shakeel-Ahamed-A/Logistics/PCB_Fabrication/FABRICATION_STATUS.md

# PROVISIONAL DESIGN - FABRICATION BLOCKED

Checked 17 October 2026 with KiCad 10.0.7. Continued the saved P0 design; no schematic, PCB, project or rule-file changes. No fabrication approval or shop archive issued.

| Status | Check | Result / exact evidence path |
|---|---|---|
| PASS | Native project preserved | `D:\Logistics\PCB_Fabrication\SmartLogistics.kicad_pro` (with same-basename `.kicad_sch`, `.kicad_pcb`, `.kicad_dru`); SHA-256 preservation evidence: `D:\Logistics\PCB_Fabrication\Evidence\native_preservation_audit.json` |
| PASS | ERC | 0 errors, 0 warnings: `D:\Logistics\PCB_Fabrication\ERC_Report.txt` |
| PASS | DRC after ground/power fixes | 0 violations, 0 unconnected pads, 0 schematic-parity issues; zones refilled in memory; exclusions included: `D:\Logistics\PCB_Fabrication\DRC_Report.txt` |
| PASS | Connectivity / library geometry | 153 connected pads match actual schematic netlist and intended map; all 63 footprints match local library pad geometry; separate AUX/Blue Pill 3.3V nets: `D:\Logistics\PCB_Fabrication\Evidence\connectivity_audit.json` |
| PASS | Actual schematic pin positions | 171 pin positions match embedded library geometry and wire endpoints/NC markers: `D:\Logistics\PCB_Fabrication\Evidence\pin_coordinate_audit.json` |
| PASS | Routing / planes | 377 track segments (225 at 0.8mm, 152 at 0.4mm), 12 vias, filled GND on both copper layers. Rules: clearance 0.3mm, copper-to-edge 0.5mm. `D:\Logistics\PCB_Fabrication\Evidence\trace_width_audit.json` |
| PASS | Review artifacts | Fresh exports visually inspected; paths below. Existing BOM and pin map revalidated without unnecessary edits. |
| PENDING | Hardware / firmware evidence | SW420 PB12 is proposed, not hardware-tested; older source uses PB15. OLED omitted until identified. No sensor failures are declared resolved. `D:\Logistics\PCB_Fabrication\Firmware_Required_Changes.txt` |
| BLOCKED | Physical / electrical release | Blue Pill spacing, actual component fit, module pin orders and circuitry, SD interface, source and shop capabilities remain unverified. Exact evidence list: `D:\Logistics\PCB_Fabrication\Verification_Required.csv` |
| BLOCKED | Manufacturing outputs | Gerbers, Excellon and `PCB_Fabrication_SHOP.zip` intentionally withheld. No Gerber inspection or fabrication approval claimed. |

PASS applies only to the stated CAD check. ERC/DRC retain the ignored checks listed in their reports; these are documented in `D:\Logistics\PCB_Fabrication\Validation_Summary.txt`. They cannot validate unknown external modules, real mechanical fit or safe operation.

## Current deliverables

- Schematic: `D:\Logistics\PCB_Fabrication\Schematic.pdf`
- Copper views: `D:\Logistics\PCB_Fabrication\PCB_Top.png` and `D:\Logistics\PCB_Fabrication\PCB_Bottom.png` (bottom viewed from underside; mirrored relative to top).
- Generic component 3D view: `D:\Logistics\PCB_Fabrication\PCB_3D.png`. Real Blue Pill/sensors are absent; generic LED model colours do not identify BOM colours.
- Assembly drawing: `D:\Logistics\PCB_Fabrication\Assembly_Drawing.pdf` (4 pages).
- Separate socket-fit sheet: `D:\Logistics\PCB_Fabrication\BluePill_Socket_Fit_1to1.pdf`. Print actual size / 100%, disable Fit-to-page, verify 50.00mm bar first. Proposed 15.24mm row spacing, 2.54mm pitch and 48.26mm pin-1-to-pin-20 span are CAD dimensions, not measurements of your module.
- BOM: `D:\Logistics\PCB_Fabrication\BOM.csv` (63 entries; procurement/assembly provisional).
- Pin map: `D:\Logistics\PCB_Fabrication\Pin_Mapping.csv` (171 symbol pins).
- Power calculations: `D:\Logistics\PCB_Fabrication\Power_Design.md`.
- Quotation specification: `D:\Logistics\PCB_Fabrication\Fabrication_Instructions.txt`.

Proposed board: **110 x 110mm, 2 copper layers, FR-4 1.6mm, 1oz copper, green mask both sides, white top legend, 2 boards**. Four M3 clearance holes: 3.2mm NPTH, 100 x 100mm centres. Header/socket holes 1.0mm; vias 0.5mm. Other drills: `D:\Logistics\PCB_Fabrication\Drill_Size_Audit.csv`. Shop acceptance is still required.

## What you must provide before release

1. **Blue Pill and sockets:** caliper-measured row centre spacing, pitch/span, module width/length, socket height and lead sizes, underside clearance and USB/SWD overhang; clear top/bottom photos showing all pin labels and regulator marking. Compare the printed fit sheet with the actual board.
2. **Modules and buzzer:** clear photos of both sides, every connector label and readable IC markings; module datasheets/schematics if available. SD needs regulator/interface IC identities, six-pin order, input supply range, 3.3V SPI input compatibility and MISO level. Identify RTC battery/charging circuitry, MPU AD0/VLOGIC and pull-ups, DHT minimum supply, GPS regulator/UART, SW420 pull-up, buzzer voltage/current/type, and the debugger model. These determine whether this draft needs electrical changes.
3. **Power and purchased parts:** identify a regulated 5V source with polarity, current limit and load capability; provide the actual component/socket part numbers or lead/body measurements. The 655mA budget / 819mA with margin are allowances, not measured maxima. Complete the relevant rail, pull-up, power-sequencing and current checks before electrical release. ST-LINK 3.3V and a raw lithium cell do not meet this input requirement.
4. **Shop response:** confirm 2-layer plated-through capability, 0.3mm clearance, 0.4mm signals / 0.8mm power, drill/annulus tolerances, 1.6mm/1oz stack, mask/silkscreen and finish, quantity 2, and turnaround before 21-22 October. Ask for acceptance of the exact drill audit, not only nominal header holes.

After those facts resolve the release blockers, approve the resulting verified revision. Any required changes must receive final ERC/DRC, connectivity and mechanical checks, followed by Gerber/Excellon export and inspection before creating the shop ZIP. Permission alone cannot substitute for the missing measurements/specifications.
