shakeel-Ahamed-A/Logistics/PCB_Fabrication/DRC_Report.txt

** Drc report for SmartLogistics.kicad_pcb **
** Created on 2026-10-17T07:41:33 **
** Report includes: Errors, Warnings, Exclusions **

** Found 0 DRC violations **

** Found 0 unconnected pads **

** Found 0 Footprint errors **

** Ignored checks **
    - Footprint has no courtyard defined
    - Track endpoint not centered on via
    - Tuning profile track geometries
    - Footprint doesn't match symbol's footprint filters
    - Footprint component type doesn't match footprint pads

** End of Report **
