shakeel-Ahamed-A/Logistics/PCB_Fabrication/ERC_Report.txt

ERC report (2026-10-17T07:41:31, Encoding UTF8)
Report includes: Errors, Warnings

***** Sheet /

 ** ERC messages: 0  Errors 0  Warnings 0

 ** Ignored checks:
    - Global label only appears once in the schematic
    - Four connection points are joined together
    - SPICE model issue
    - Assigned footprint doesn't match footprint filters
