shakeel-Ahamed-A/Logistics/PCB_Fabrication/Evidence/schematic_review.png

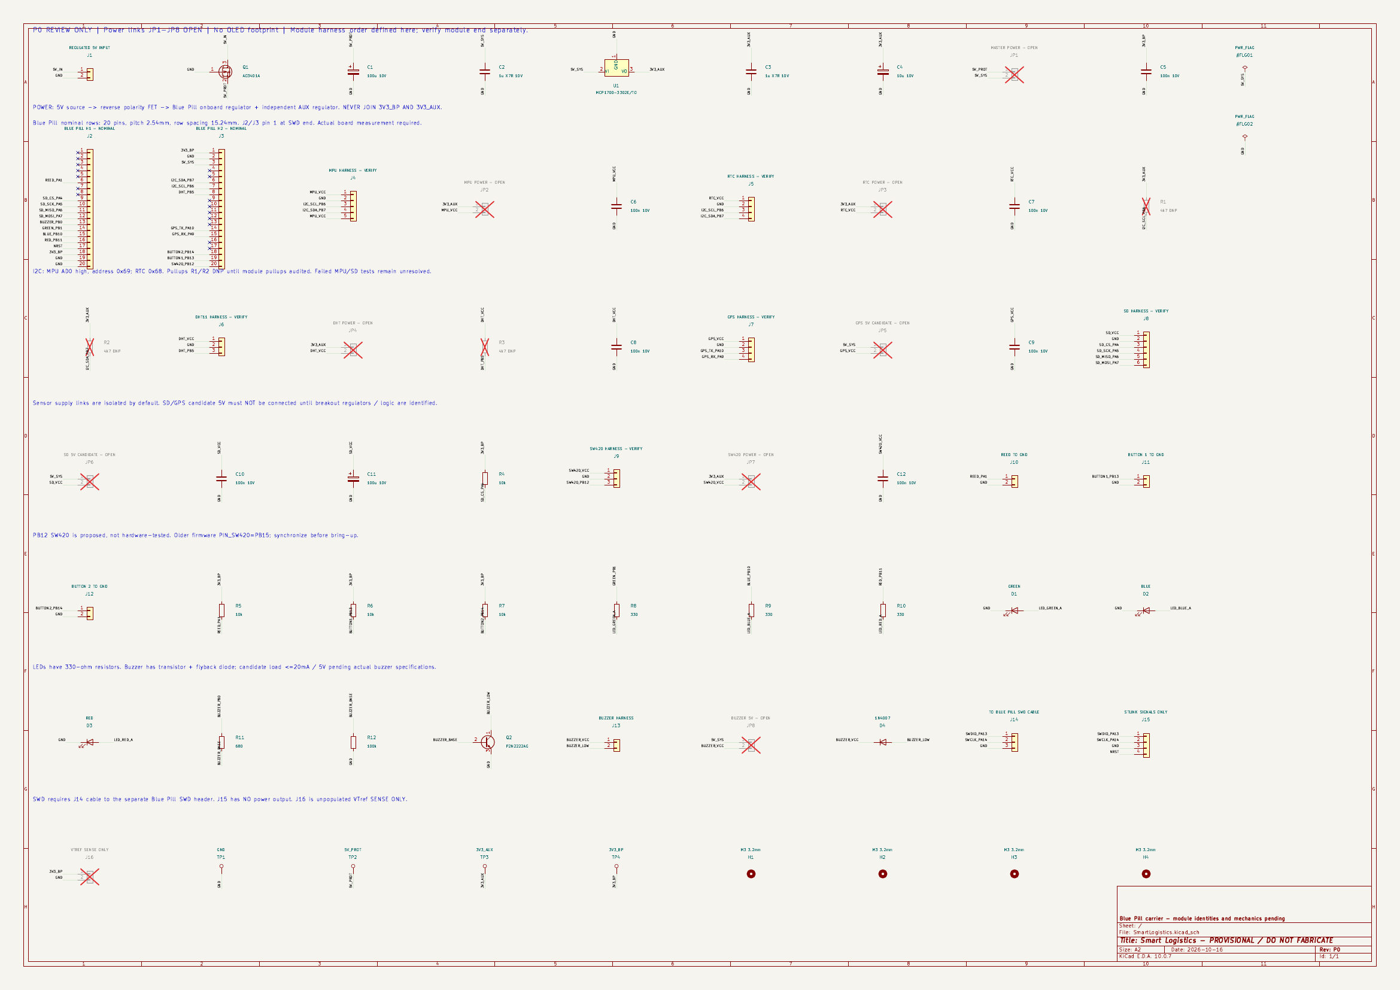
PCB_Fabrication/Evidence/schematic_review.png
