shakeel-Ahamed-A/Logistics/PCB_Fabrication/Assembly_Drawing.pdf

2 | 1 | 2

# BLUE PILL: SWD END USB / NO POWER

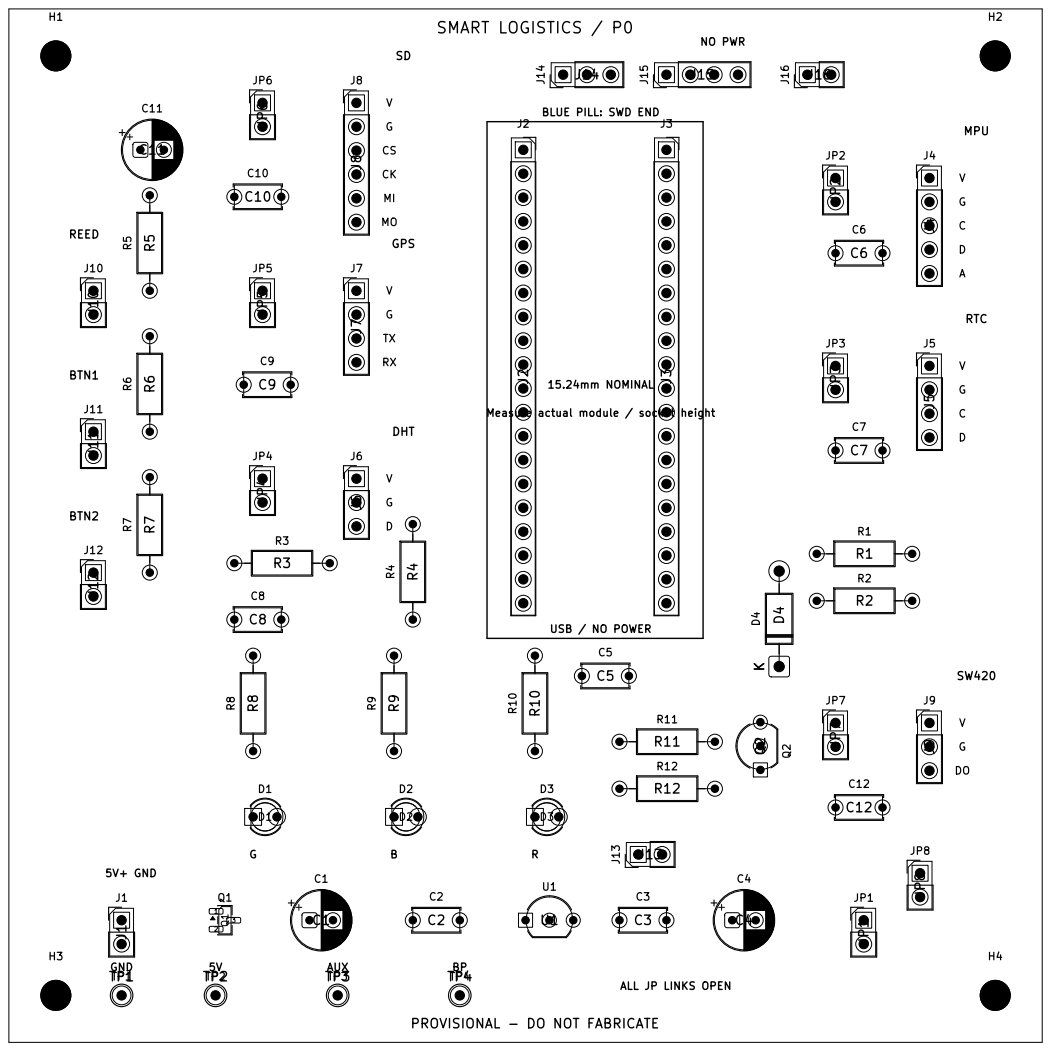
[picture p2: page 1]

SW420 PROVISIONAL - DO NOT FABRICATE

ALL JP LINKS OPEN

# Blue Pill socket fit check - print at 100%

P0 - PROVISIONAL / DO NOT FABRICATE - 16 October 2026

Check the 50 mm bar with a ruler before using this page.
Two rows: 20 pins, 2.54 mm pitch; proposed row spacing 15.24 mm. Pitch span pin 1 to pin 20 = 48.26 mm. Actual board still unmeasured. Top view: SWD end above; USB end below. Check actual pin labels.
J2 is the VBAT row; J3 is the 3V3/5V row. Do not mirror the carrier.
Measure module width/length/height, socket height and SWD/USB overhang. 3D rendering excludes the real Blue Pill and sensors: clearance is PENDING.
J2 / VBAT | J3 / 3V3

USB end

15.24 mm

50.00 mm calibration bar

FIT NOT APPROVED: compare this coupon with your actual board before fabrication.

# Carrier connector pinout - module end must be verified

P0 - PROVISIONAL / DO NOT FABRICATE - 16 October 2026

J1 REGULATED 5V INPUT
1=5V_IN | 2=GND

J4 MPU HARNESS - VERIFY
1=MPU_VCC | 2=GND | 3=I2C_SCL_PB6 | 4=I2C_SDA_PB7 | 5=MPU_VCC

J5 RTC HARNESS - VERIFY
1=RTC_VCC | 2=GND | 3=I2C_SCL_PB6 | 4=I2C_SDA_PB7

J6 DHT11 HARNESS - VERIFY
1=DHT_VCC | 2=GND | 3=DHT_PB5

J7 GPS HARNESS - VERIFY
1=GPS_VCC | 2=GND | 3=GPS_TX_PA10 | 4=GPS_RX_PA9

J8 SD HARNESS - VERIFY
1=SD_VCC | 2=GND | 3=SD_CS_PA4 | 4=SD_SCK_PA5 | 5=SD_MISO_PA6 | 6=SD_MOSI_PA7

J9 SW420 HARNESS - VERIFY
1=SW420_VCC | 2=GND | 3=SW420_PB12

J10 REED TO GND
1=REED_PA1 | 2=GND

J11 BUTTON 1 TO GND
1=BUTTON1_PB13 | 2=GND

J12 BUTTON 2 TO GND
1=BUTTON2_PB14 | 2=GND

J13 BUZZER HARNESS
1=BUZZER_VCC | 2=BUZZER_LOW

J14 TO BLUE PILL SWD CABLE
1=SWDIO_PA13 | 2=SWCLK_PA14 | 3=GND

# Carrier connector pinout - continued

P0 - PROVISIONAL / DO NOT FABRICATE - 16 October 2026

J15 STLINK SIGNALS ONLY
1=SWDIO_PA13 | 2=SWCLK_PA14 | 3=GND | 4=NRST

J16 VTREF SENSE ONLY
1=3V3_BP | 2=GND

JP1-JP8 OPEN; R1/R2/R3 and J16 DNP. Supply links do not isolate signal pins. No hot-plugging.
