shakeel-Ahamed-A/Logistics/PCB_Fabrication/Evidence/deliverable_manifest_2026-10-17.csv

File | Bytes | SHA256
SmartLogistics.kicad_pro | 10886 | E0B03D3DEB09930143914720F2330A69D12332298C9900A74E2AC4BA2886E590
SmartLogistics.kicad_sch | 122158 | 0117FFA0E297E57C0BC1CEB7E60B631A9887A0E6D31DAA01ED794CC223B14C6B
SmartLogistics.kicad_pcb | 934197 | 785D359CF4CCF2E02C0F8CE3CC1FE7EC6728022C070E47972B8DF3F7502BA60E
Schematic.pdf | 239423 | 2B0F0AB58E1A72B0EDD6D653A7BE5641440691FF0424902957333B341672E528
PCB_Top.png | 135147 | 4C4996BE035E1A4967922B69DF3953BAA0C7BEB60CA14EB94CC90923F4AF2416
PCB_Bottom.png | 92383 | 9AC5950159DA061FB94056811526A578A12254003A93DCA5F60C3259492A8214
PCB_3D.png | 937522 | 4A041196A1BA4F14B52FE7E1CF56EB233078E97ABADD62933EB77A4D6111E7F5
BOM.csv | 8652 | C178DC051E8BF49569F7BF5DF030CC4750218132B17C67C21DA6A05D34F6706A
Assembly_Drawing.pdf | 130162 | F259F997493364847925471E2DCD3E82919324C1B30040D9BC3572363D42DDE5
BluePill_Socket_Fit_1to1.pdf | 6426 | 0789B1E35FCFAD7AD71749B9A85609A1791B13582C4183AB9BE37BB0E3D516BD
Pin_Mapping.csv | 25627 | 8E9D8F09611E90FA6A64925881F6A8D188995335085CBC049EA41CE146AE5B6F
ERC_Report.txt | 357 | FDBCACB988917C4F417336B03FF8CD654F0D8062EE86C7E238AA134C578A87F8
DRC_Report.txt | 527 | 259289A7A92B25DFC1020222DE931174C3F6F8B82DF2706BD198CFBFE46B3561
FABRICATION_STATUS.md | 5954 | 6B650A23724ACC0A3386B8631878AAA5DEBCD6B808A0D79F757B112968E7C7D5
Validation_Summary.txt | 3446 | 2B7027F9833E677A411DC9A17BABC8180BBE37B08D0E36B4CF4C59D73FB6B27B
Fabrication_Instructions.txt | 2612 | E7D7039D299556E405F621EAA11292CCCA48B4EC702ACFF4631DE08058164A96
