shakeel-Ahamed-A/Logistics/PCB_Fabrication/Evidence/assembly_review-1.png

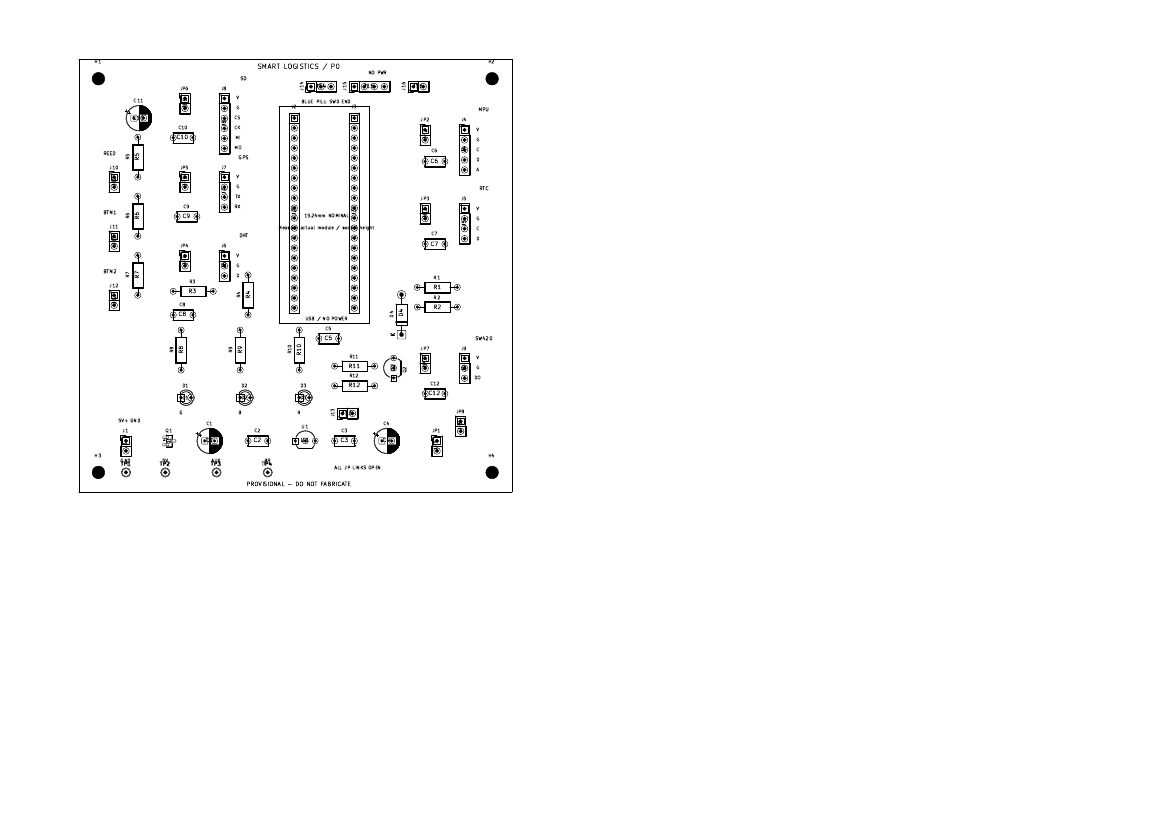
PCB_Fabrication/Evidence/assembly_review-1.png
