shakeel-Ahamed-A/Logistics/PCB_Fabrication/Evidence/assembly_review-2.png

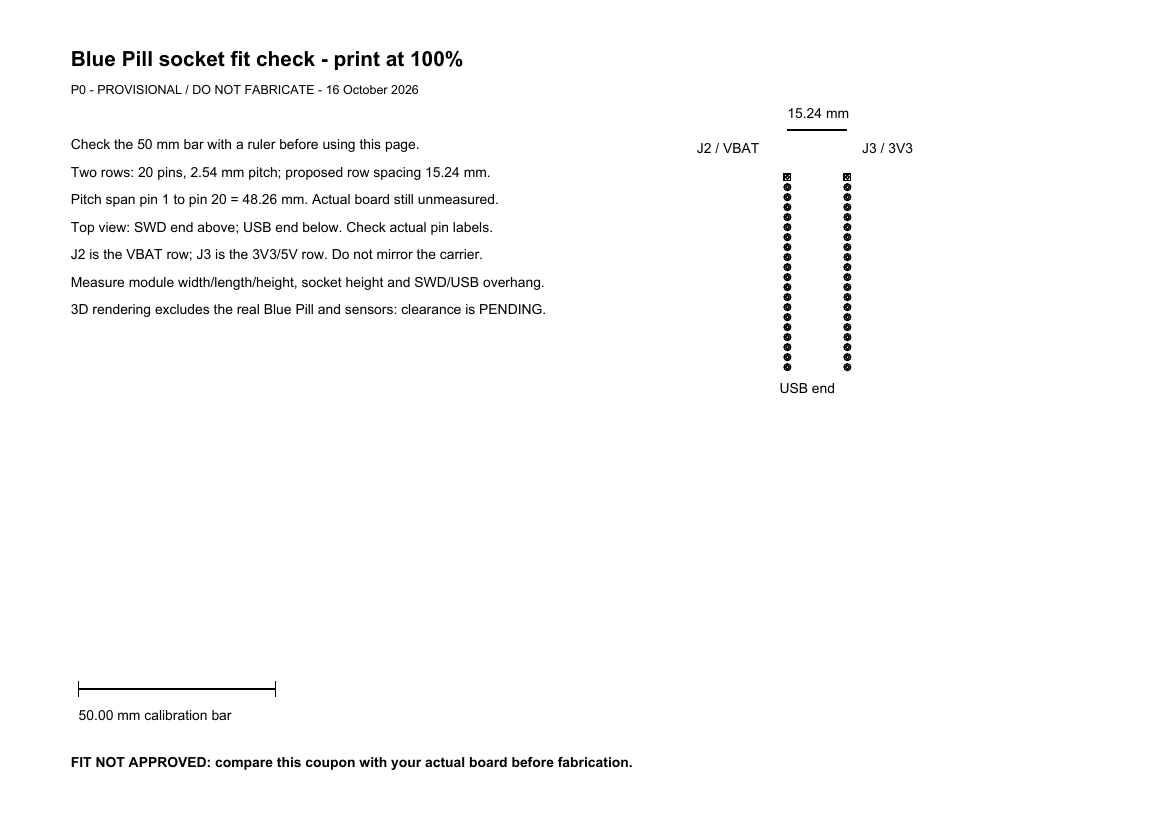
PCB_Fabrication/Evidence/assembly_review-2.png
