shakeel-Ahamed-A/Logistics/PCB_Fabrication/Evidence/assembly_review-3.png

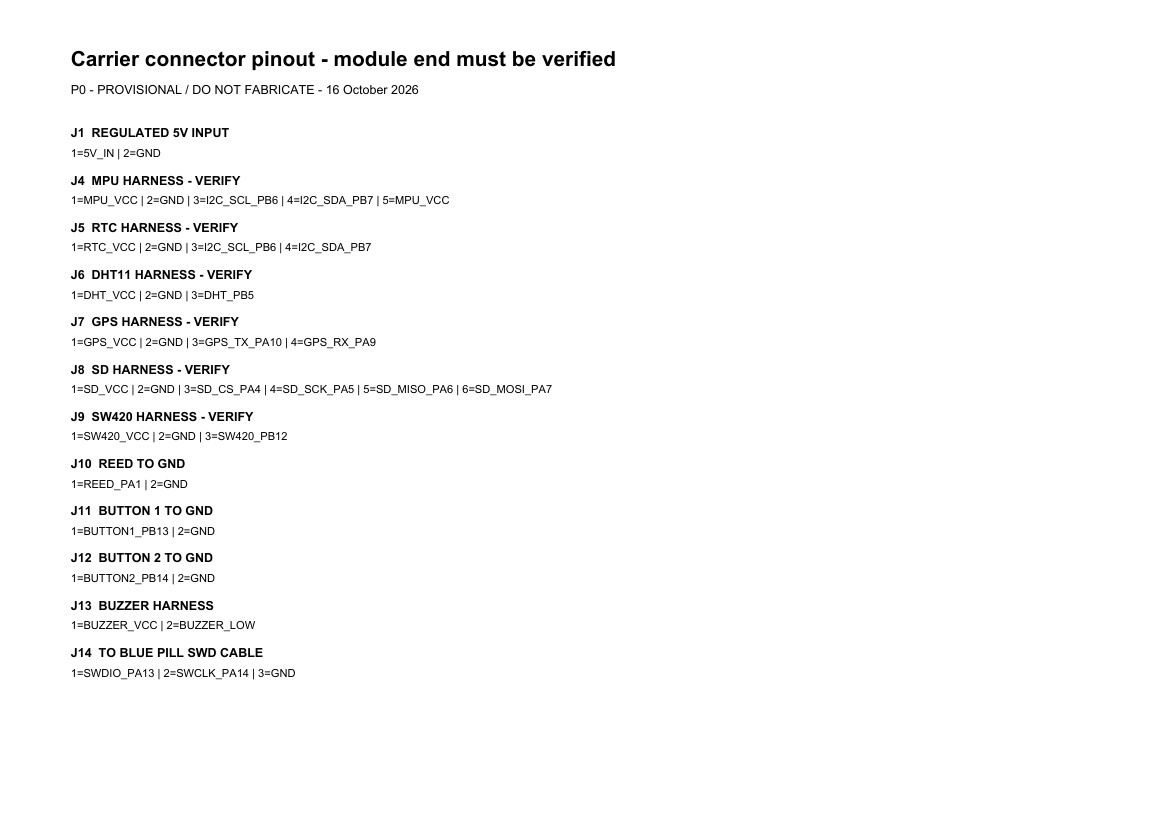
PCB_Fabrication/Evidence/assembly_review-3.png
