shakeel-Ahamed-A/Logistics/PCB_Fabrication/Evidence/assembly_review-4.png

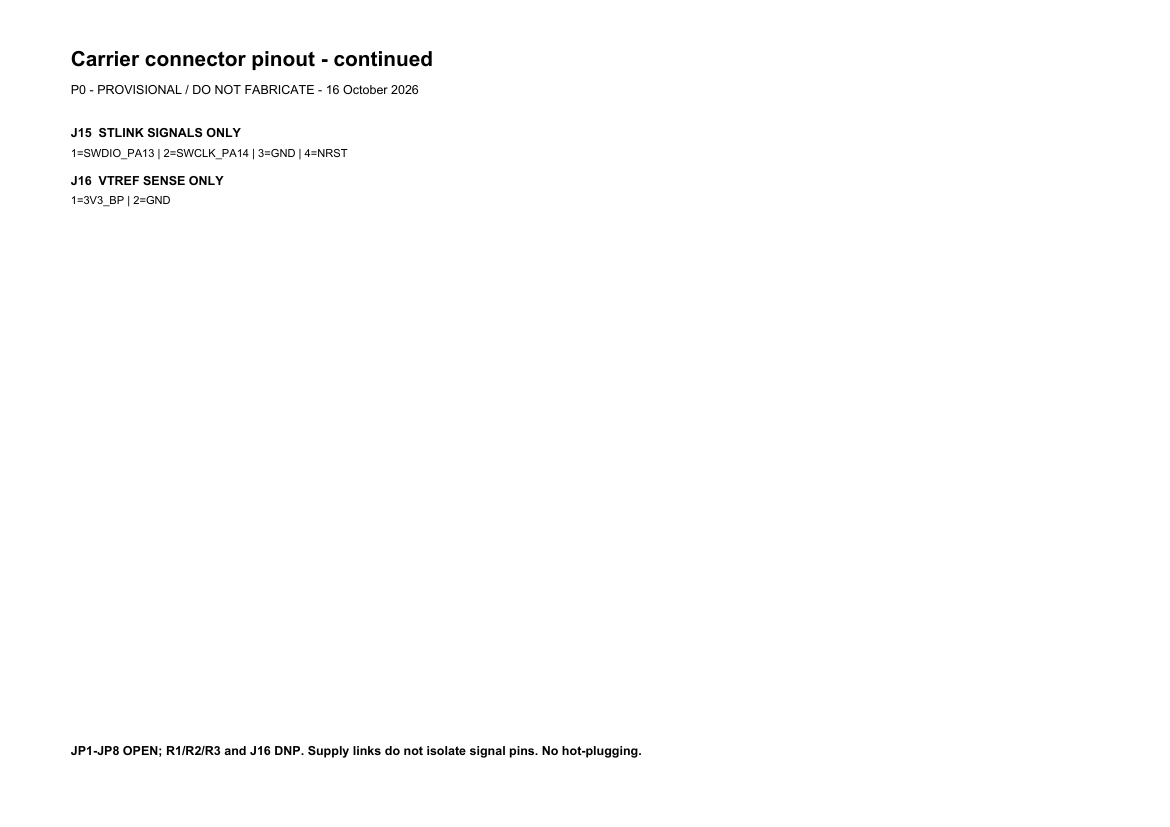
PCB_Fabrication/Evidence/assembly_review-4.png
