shakeel-Ahamed-A/Logistics/PCB_Fabrication/PCB_3D.png

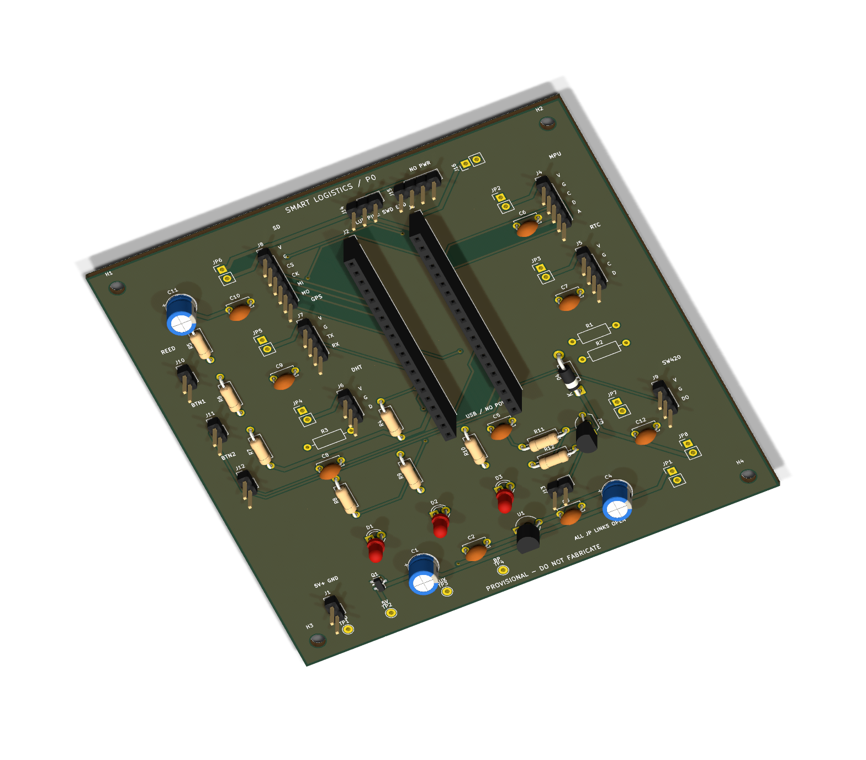
PCB_Fabrication/PCB_3D.png
