shakeel-Ahamed-A/Logistics/PCB_Fabrication/PCB_Bottom.png

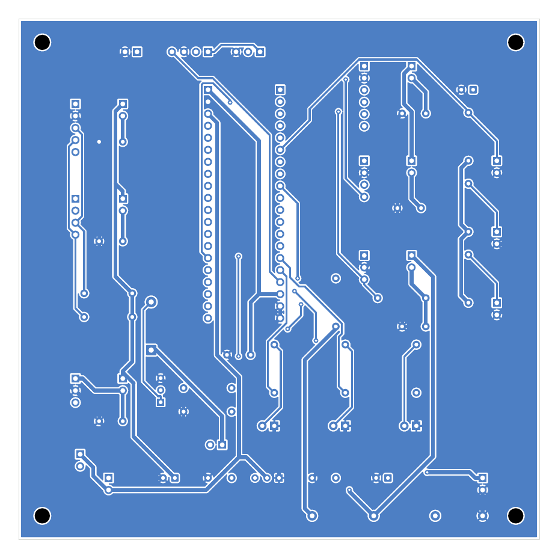
PCB_Fabrication/PCB_Bottom.png
