shakeel-Ahamed-A/Logistics/PCB_Fabrication/PCB_Top.png

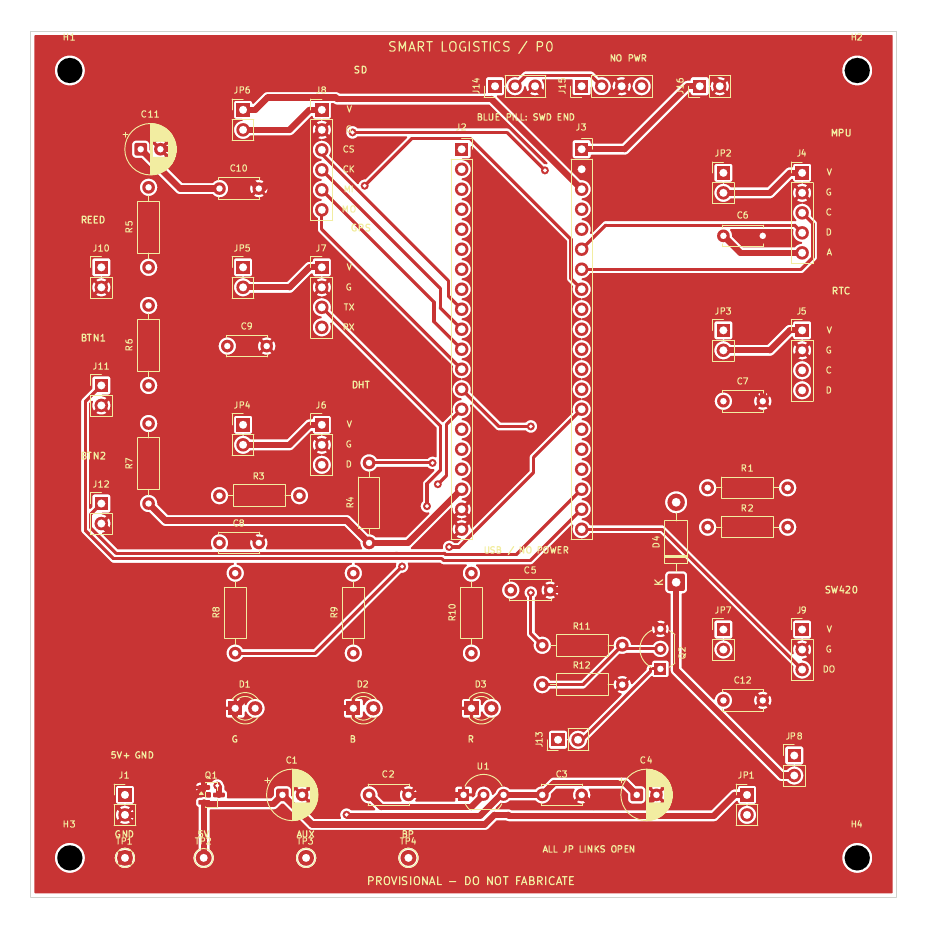
PCB_Fabrication/PCB_Top.png
