shakeel-Ahamed-A/Logistics/PCB_Fabrication/Schematic.pdf

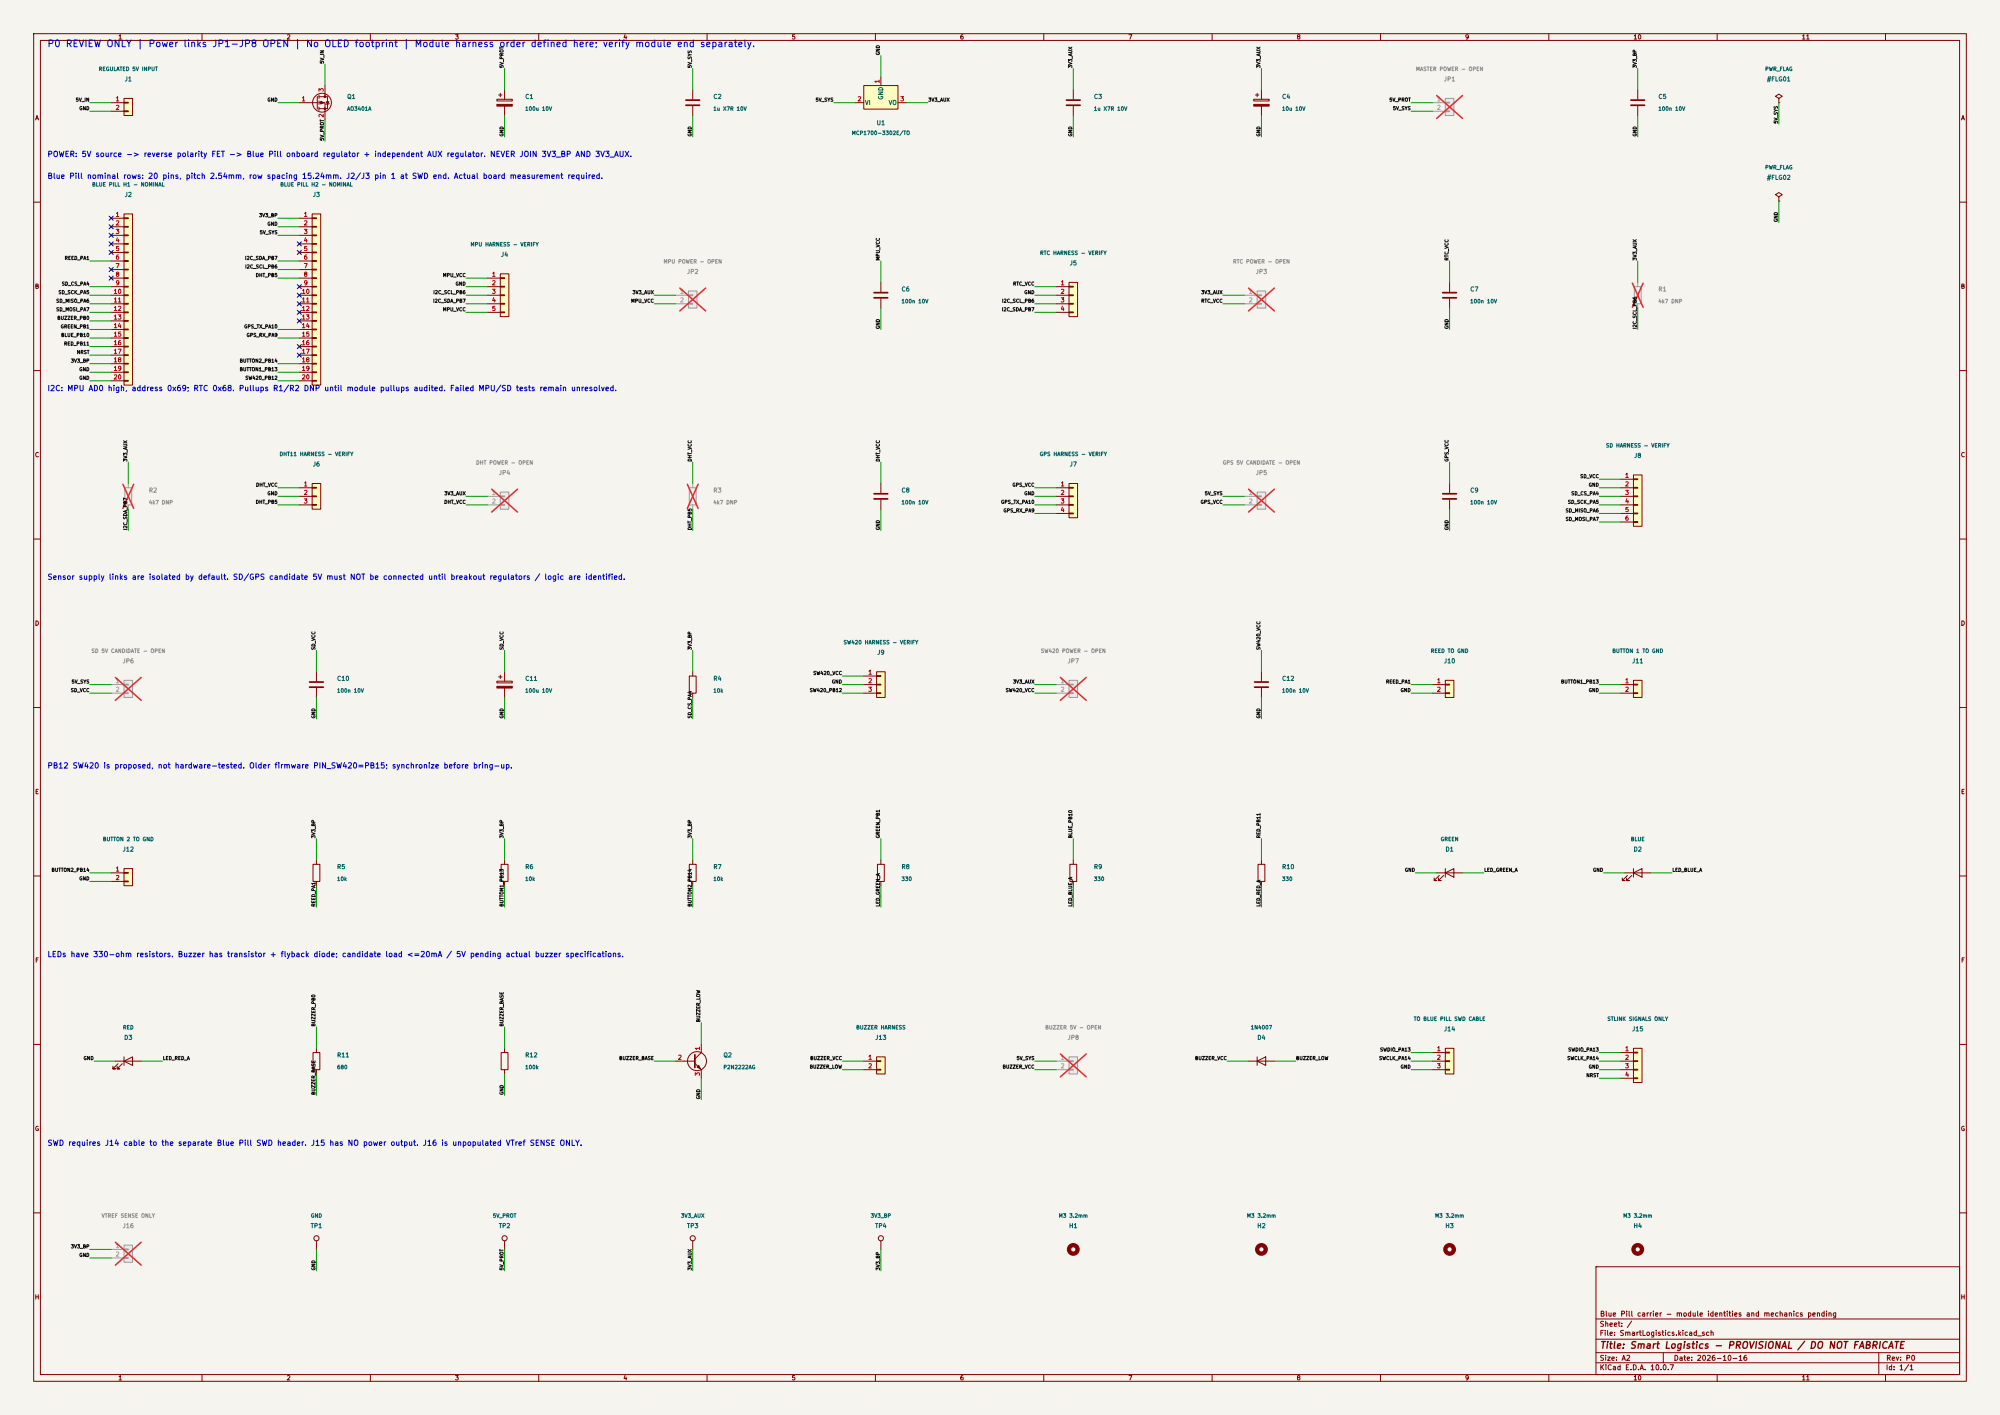
[picture p10: page 1]

P0 REVIEW ONLY | Power links JP1-JP8 OPEN | No OLED footprint | Module harness order defined here; verify module end separately.

POWER: 5V source -> reverse polarity FET -> Blue Pill onboard regulator + independent AUX regulator. NEVER JOIN 3V3_BP AND 3V3_AUX.

Blue Pill nominal rows: 20 pins, pitch 2.54mm, row spacing 15.24mm. J2/J3 pin 1 at SWD end. Actual board measurement required.

I2C: MPU AD0 high, address 0x69; RTC 0x68. Pullups R1/R2 DNP until module pullups audited. Failed MPU/SD tests remain unresolved.

Sensor supply links are isolated by default. SD/GPS candidate 5V must NOT be connected until breakout regulators / logic are identified.

GND LEDs have 330-ohm resistors. Buzzer has transistor + flyback diode; candidate load <=20mA / 5V pending actual buzzer specifications.

PB12 SW420 is proposed, not hardware-tested. Older firmware PIN_SW420=PB15; synchronize before bring-up.

SWD requires J14 cable to the separate Blue Pill SWD header. J15 has NO power output. J16 is unpopulated VTref SENSE ONLY.

Blue Pill carrier - module identities and mechanics pending
Sheet: /
File: SmartLogistics.kicad_sch
Title: Smart Logistics - PROVISIONAL / DO NOT FABRICATE

Size: A2 | Rev: P0
KiCad E.D.A. 10.0.7 | Id: 1/1
