shakeel-Ahamed-A/Logistics/PCB_Fabrication/Evidence/Assembly_1to1.pdf

SMART LOGISTICS / P0
BLUE PILL: SWD END USB / NO POWER

SW420 PROVISIONAL - DO NOT FABRICATE

ALL JP LINKS OPEN
