shakeel-Ahamed-A/Logistics/PCB_Fabrication/Evidence/PCB_Bottom.pdf

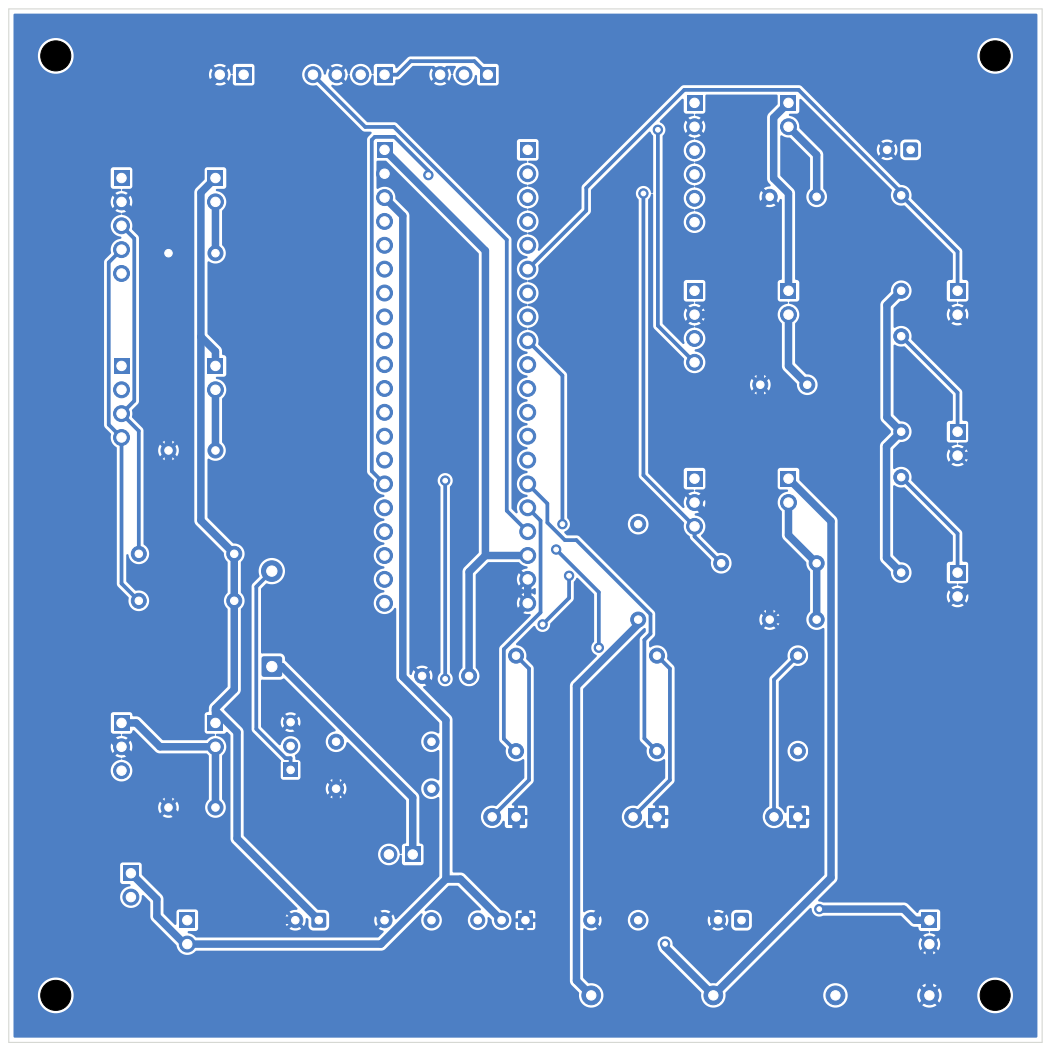
[picture p11: page 1]
