shakeel-Ahamed-A/Logistics/(list of files, drawings)

Other design files:
PCB_Fabrication/Evidence/SmartLogistics.dsn
