shakeel-Ahamed-A/Logistics/PCB_Fabrication/SmartLogistics.kicad_pcb

## KiCad design PCB_Fabrication/SmartLogistics.kicad_pcb (2026-10-17)

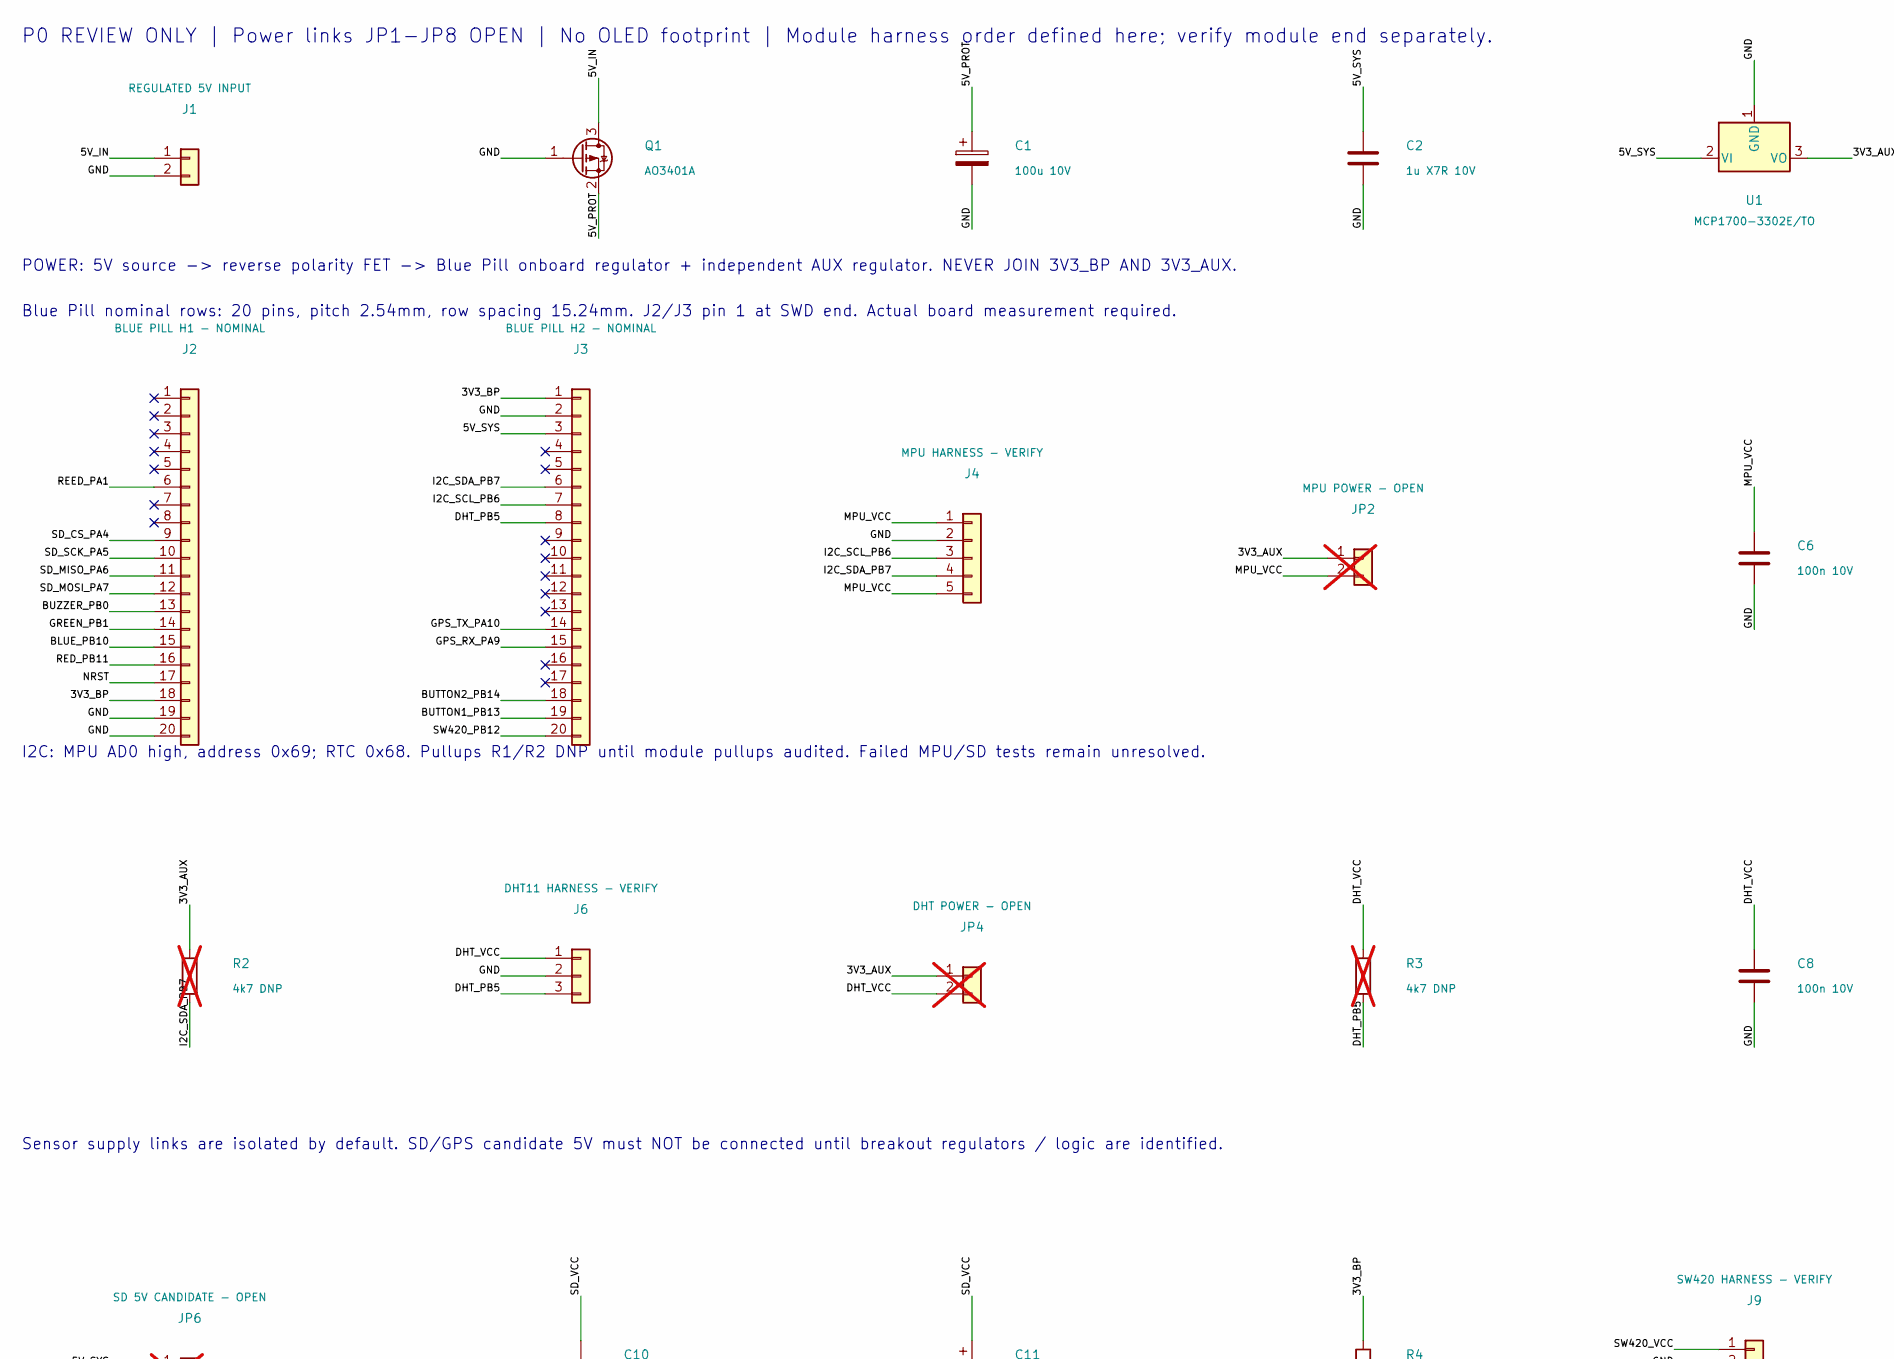
[picture p12: schematic SmartLogistics.kicad_sch, Smart Logistics - PROVISIONAL / DO NOT FABRICATE, part in row 1, column 1]

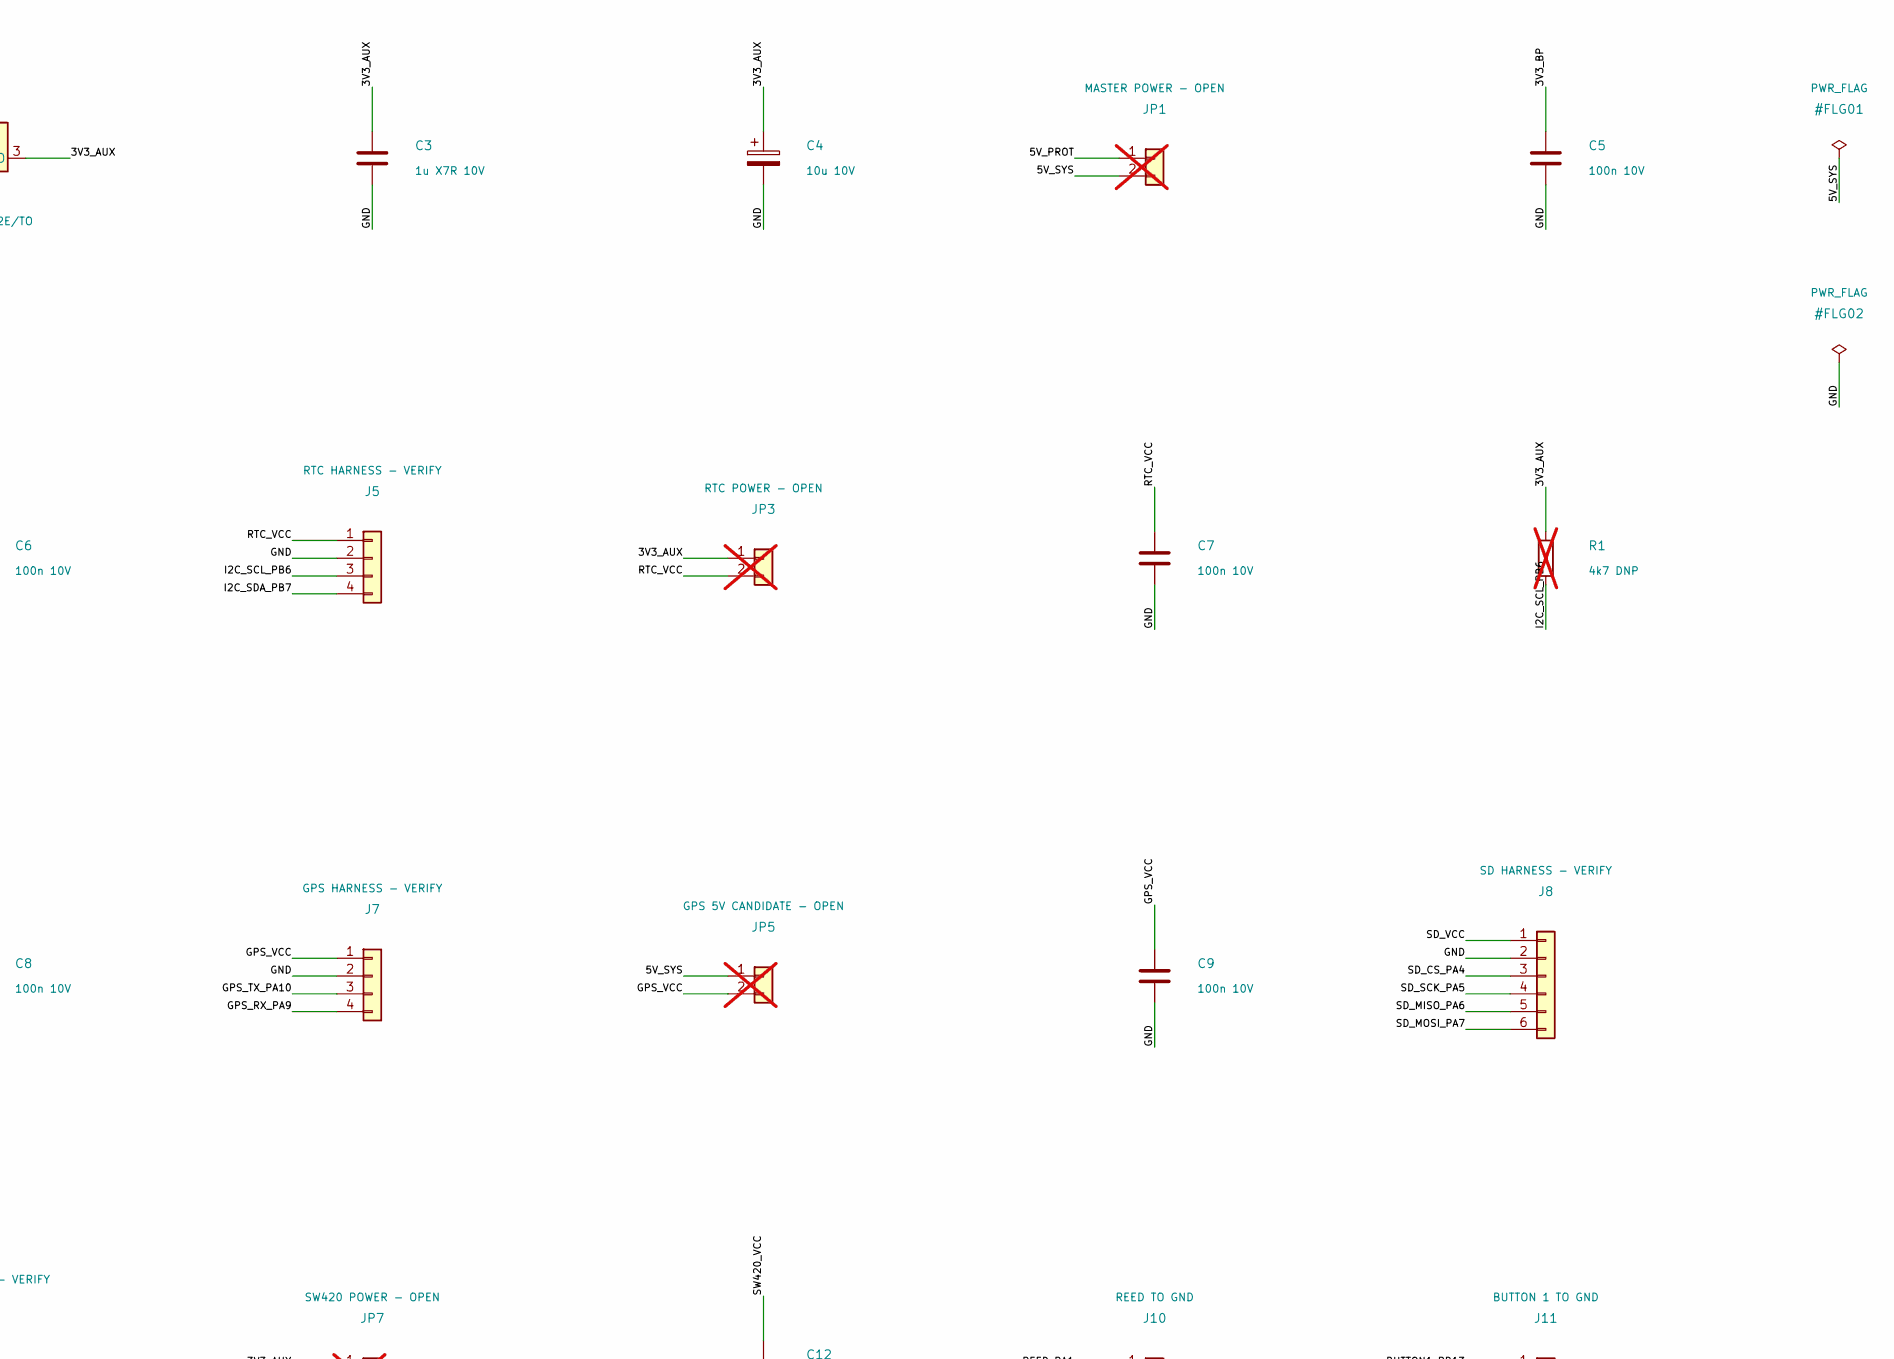
[picture p13: schematic SmartLogistics.kicad_sch, Smart Logistics - PROVISIONAL / DO NOT FABRICATE, part in row 1, column 2]

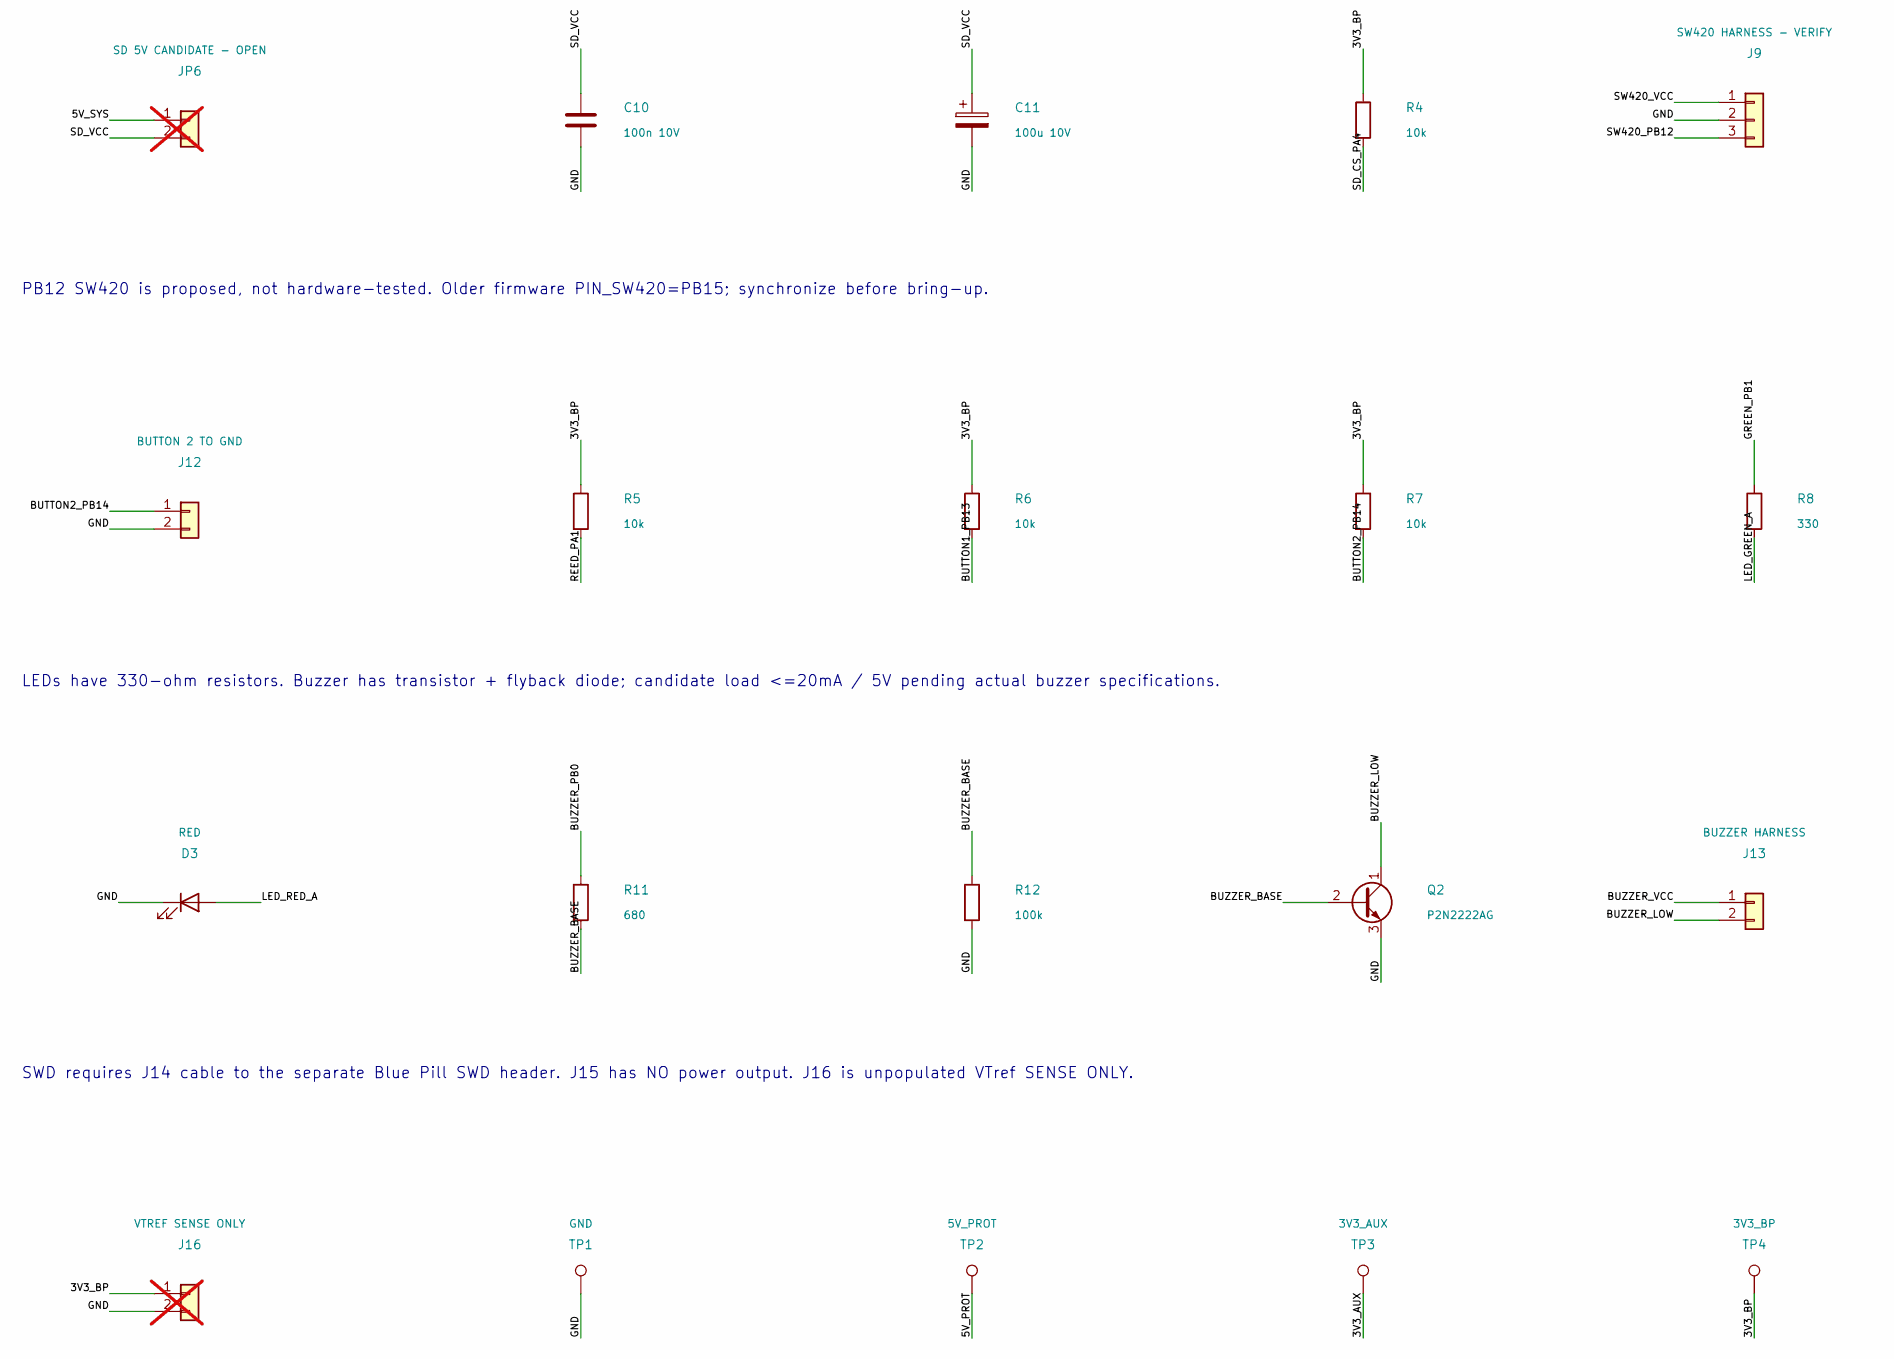
[picture p14: schematic SmartLogistics.kicad_sch, Smart Logistics - PROVISIONAL / DO NOT FABRICATE, part in row 2, column 1]

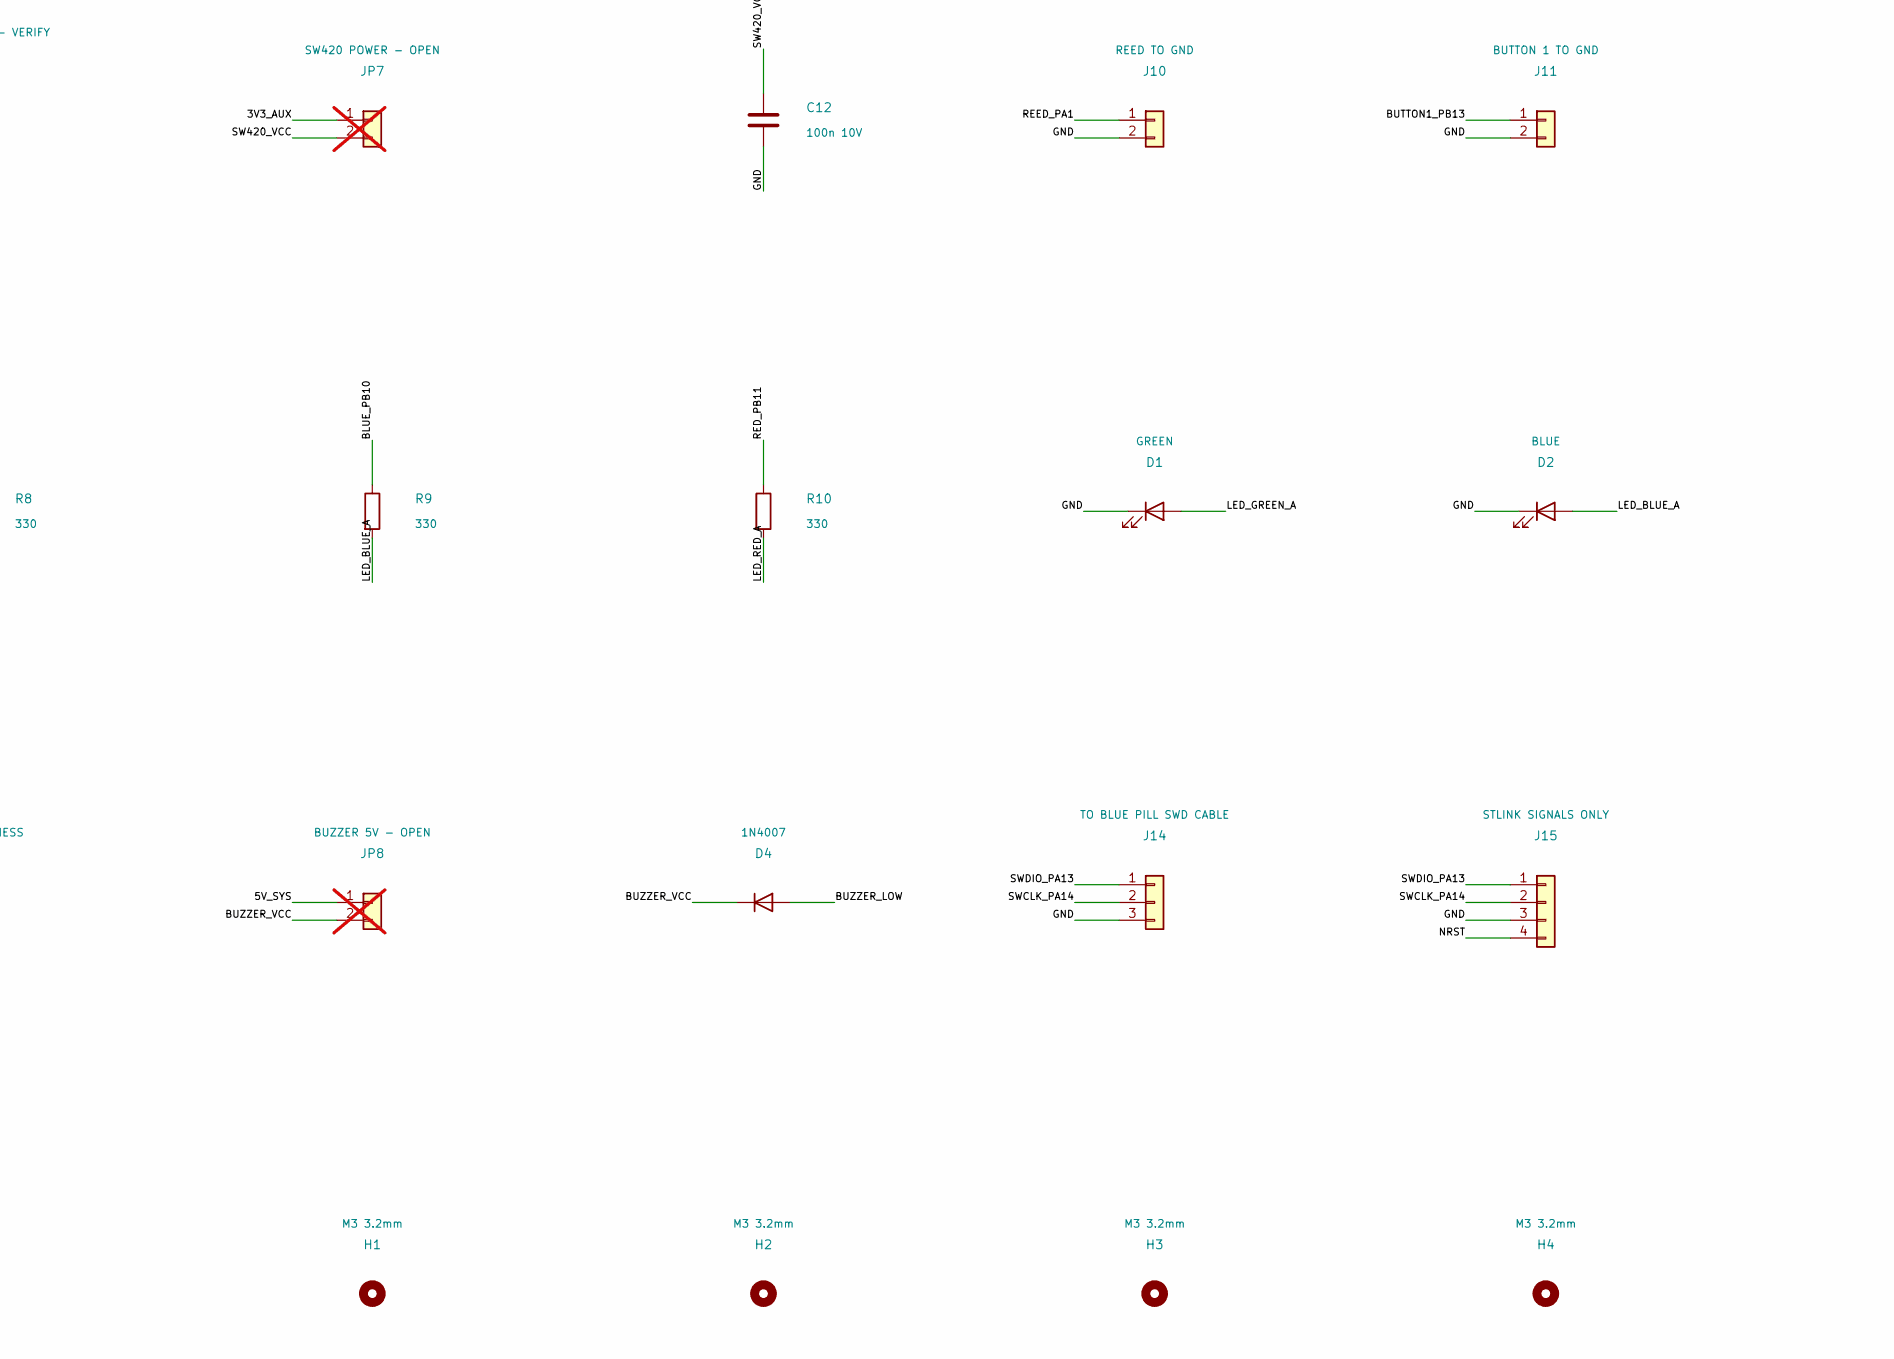
[picture p15: schematic SmartLogistics.kicad_sch, Smart Logistics - PROVISIONAL / DO NOT FABRICATE, part in row 2, column 2]

Parts:
C1, C11: 100u 10V; CP_Radial_D6.3mm_P2.50mm
C2, C3: 1u X7R 10V; C_Disc_D5.0mm_W2.5mm_P5.00mm
C4: 10u 10V; CP_Radial_D6.3mm_P2.50mm
C5, C6, C7, C8, C9, C10, C12: 100n 10V; C_Disc_D5.0mm_W2.5mm_P5.00mm
D1: GREEN; LED_D3.0mm
D2: BLUE; LED_D3.0mm
D3: RED; LED_D3.0mm
D4: 1N4007; D_DO-41_SOD81_P10.16mm_Horizontal
H1, H2, H3, H4: M3 3.2mm; MountingHole_3.2mm_M3
J1: REGULATED 5V INPUT; PinHeader_1x02_P2.54mm_Vertical
J2: BLUE PILL H1 - NOMINAL; PinSocket_1x20_P2.54mm_Vertical
J3: BLUE PILL H2 - NOMINAL; PinSocket_1x20_P2.54mm_Vertical
J4: MPU HARNESS - VERIFY; PinHeader_1x05_P2.54mm_Vertical
J5: RTC HARNESS - VERIFY; PinHeader_1x04_P2.54mm_Vertical
J6: DHT11 HARNESS - VERIFY; PinHeader_1x03_P2.54mm_Vertical
J7: GPS HARNESS - VERIFY; PinHeader_1x04_P2.54mm_Vertical
J8: SD HARNESS - VERIFY; PinHeader_1x06_P2.54mm_Vertical
J9: SW420 HARNESS - VERIFY; PinHeader_1x03_P2.54mm_Vertical
J10: REED TO GND; PinHeader_1x02_P2.54mm_Vertical
J11: BUTTON 1 TO GND; PinHeader_1x02_P2.54mm_Vertical
J12: BUTTON 2 TO GND; PinHeader_1x02_P2.54mm_Vertical
J13: BUZZER HARNESS; PinHeader_1x02_P2.54mm_Vertical
J14: TO BLUE PILL SWD CABLE; PinHeader_1x03_P2.54mm_Vertical
J15: STLINK SIGNALS ONLY; PinHeader_1x04_P2.54mm_Vertical
J16: VTREF SENSE ONLY; PinHeader_1x02_P2.54mm_Vertical; not fitted
JP1: MASTER POWER - OPEN; PinHeader_1x02_P2.54mm_Vertical; not fitted
JP2: MPU POWER - OPEN; PinHeader_1x02_P2.54mm_Vertical; not fitted
JP3: RTC POWER - OPEN; PinHeader_1x02_P2.54mm_Vertical; not fitted
JP4: DHT POWER - OPEN; PinHeader_1x02_P2.54mm_Vertical; not fitted
JP5: GPS 5V CANDIDATE - OPEN; PinHeader_1x02_P2.54mm_Vertical; not fitted
JP6: SD 5V CANDIDATE - OPEN; PinHeader_1x02_P2.54mm_Vertical; not fitted
JP7: SW420 POWER - OPEN; PinHeader_1x02_P2.54mm_Vertical; not fitted
JP8: BUZZER 5V - OPEN; PinHeader_1x02_P2.54mm_Vertical; not fitted
Q1: AO3401A; SOT-23
Q2: P2N2222AG; TO-92_Inline_Wide
R1, R2, R3: 4k7 DNP; R_Axial_DIN0207_L6.3mm_D2.5mm_P10.16mm_Horizontal; not fitted
R4, R5, R6, R7: 10k; R_Axial_DIN0207_L6.3mm_D2.5mm_P10.16mm_Horizontal
R8, R9, R10: 330; R_Axial_DIN0207_L6.3mm_D2.5mm_P10.16mm_Horizontal
R11: 680; R_Axial_DIN0207_L6.3mm_D2.5mm_P10.16mm_Horizontal
R12: 100k; R_Axial_DIN0207_L6.3mm_D2.5mm_P10.16mm_Horizontal
TP1: GND; TestPoint_THTPad_D2.0mm_Drill1.0mm
TP2: 5V_PROT; TestPoint_THTPad_D2.0mm_Drill1.0mm
TP3: 3V3_AUX; TestPoint_THTPad_D2.0mm_Drill1.0mm
TP4: 3V3_BP; TestPoint_THTPad_D2.0mm_Drill1.0mm
U1: MCP1700-3302E/TO; TO-92_Inline_Wide

Connections:
/3V3_AUX: C3.1, C4.1, JP2.1, JP3.1, JP4.1, JP7.1, R1.1, R2.1, TP3.1, U1.3 (VO)
/3V3_BP: C5.1, J2.18, J3.1, J16.1, R4.1, R5.1, R6.1, R7.1, TP4.1
/5V_IN: J1.1, Q1.3 (D)
/5V_PROT: C1.1, JP1.1, Q1.2 (S), TP2.1
/5V_SYS: C2.1, J3.3, JP1.2, JP5.1, JP6.1, JP8.1, U1.2 (VI)
/BLUE_PB10: J2.15, R9.1
/BUTTON1_PB13: J3.19, J11.1, R6.2
/BUTTON2_PB14: J3.18, J12.1, R7.2
/BUZZER_BASE: Q2.2 (B), R11.2, R12.1
/BUZZER_LOW: D4.2 (A), J13.2, Q2.1 (C)
/BUZZER_PB0: J2.13, R11.1
/BUZZER_VCC: D4.1 (K), J13.1, JP8.2
/DHT_PB5: J3.8, J6.3, R3.2
/DHT_VCC: C8.1, J6.1, JP4.2, R3.1
/GND: C1.2, C2.2, C3.2, C4.2, C5.2, C6.2, C7.2, C8.2, C9.2, C10.2, C11.2, C12.2, D1.1 (K), D2.1 (K), D3.1 (K), J1.2, J2.19, J2.20, J3.2, J4.2, J5.2, J6.2, J7.2, J8.2, J9.2, J10.2, J11.2, J12.2, J14.3, J15.3, J16.2, Q1.1 (G), Q2.3 (E), R12.2, TP1.1, U1.1 (GND)
/GPS_RX_PA9: J3.15, J7.4
/GPS_TX_PA10: J3.14, J7.3
/GPS_VCC: C9.1, J7.1, JP5.2
/GREEN_PB1: J2.14, R8.1
/I2C_SCL_PB6: J3.7, J4.3, J5.3, R1.2
/I2C_SDA_PB7: J3.6, J4.4, J5.4, R2.2
/LED_BLUE_A: D2.2 (A), R9.2
/LED_GREEN_A: D1.2 (A), R8.2
/LED_RED_A: D3.2 (A), R10.2
/MPU_VCC: C6.1, J4.1, J4.5, JP2.2
/NRST: J2.17, J15.4
/RED_PB11: J2.16, R10.1
/REED_PA1: J2.6, J10.1, R5.2
/RTC_VCC: C7.1, J5.1, JP3.2
/SD_CS_PA4: J2.9, J8.3, R4.2
/SD_MISO_PA6: J2.11, J8.5
/SD_MOSI_PA7: J2.12, J8.6
/SD_SCK_PA5: J2.10, J8.4
/SD_VCC: C10.1, C11.1, J8.1, JP6.2
/SW420_PB12: J3.20, J9.3
/SW420_VCC: C12.1, J9.1, JP7.2
/SWCLK_PA14: J14.2, J15.2
/SWDIO_PA13: J14.1, J15.1

Notes on the sheet:
P0 REVIEW ONLY | Power links JP1-JP8 OPEN | No OLED footprint | Module harness order defined here; verify module end separately.
POWER: 5V source -> reverse polarity FET -> Blue Pill onboard regulator + independent AUX regulator. NEVER JOIN 3V3_BP AND 3V3_AUX.
Blue Pill nominal rows: 20 pins, pitch 2.54mm, row spacing 15.24mm. J2/J3 pin 1 at SWD end. Actual board measurement required.
I2C: MPU AD0 high, address 0x69; RTC 0x68. Pullups R1/R2 DNP until module pullups audited. Failed MPU/SD tests remain unresolved.
Sensor supply links are isolated by default. SD/GPS candidate 5V must NOT be connected until breakout regulators / logic are identified.
PB12 SW420 is proposed, not hardware-tested. Older firmware PIN_SW420=PB15; synchronize before bring-up.
LEDs have 330-ohm resistors. Buzzer has transistor + flyback diode; candidate load <=20mA / 5V pending actual buzzer specifications.
SWD requires J14 cable to the separate Blue Pill SWD header. J15 has NO power output. J16 is unpopulated VTref SENSE ONLY.

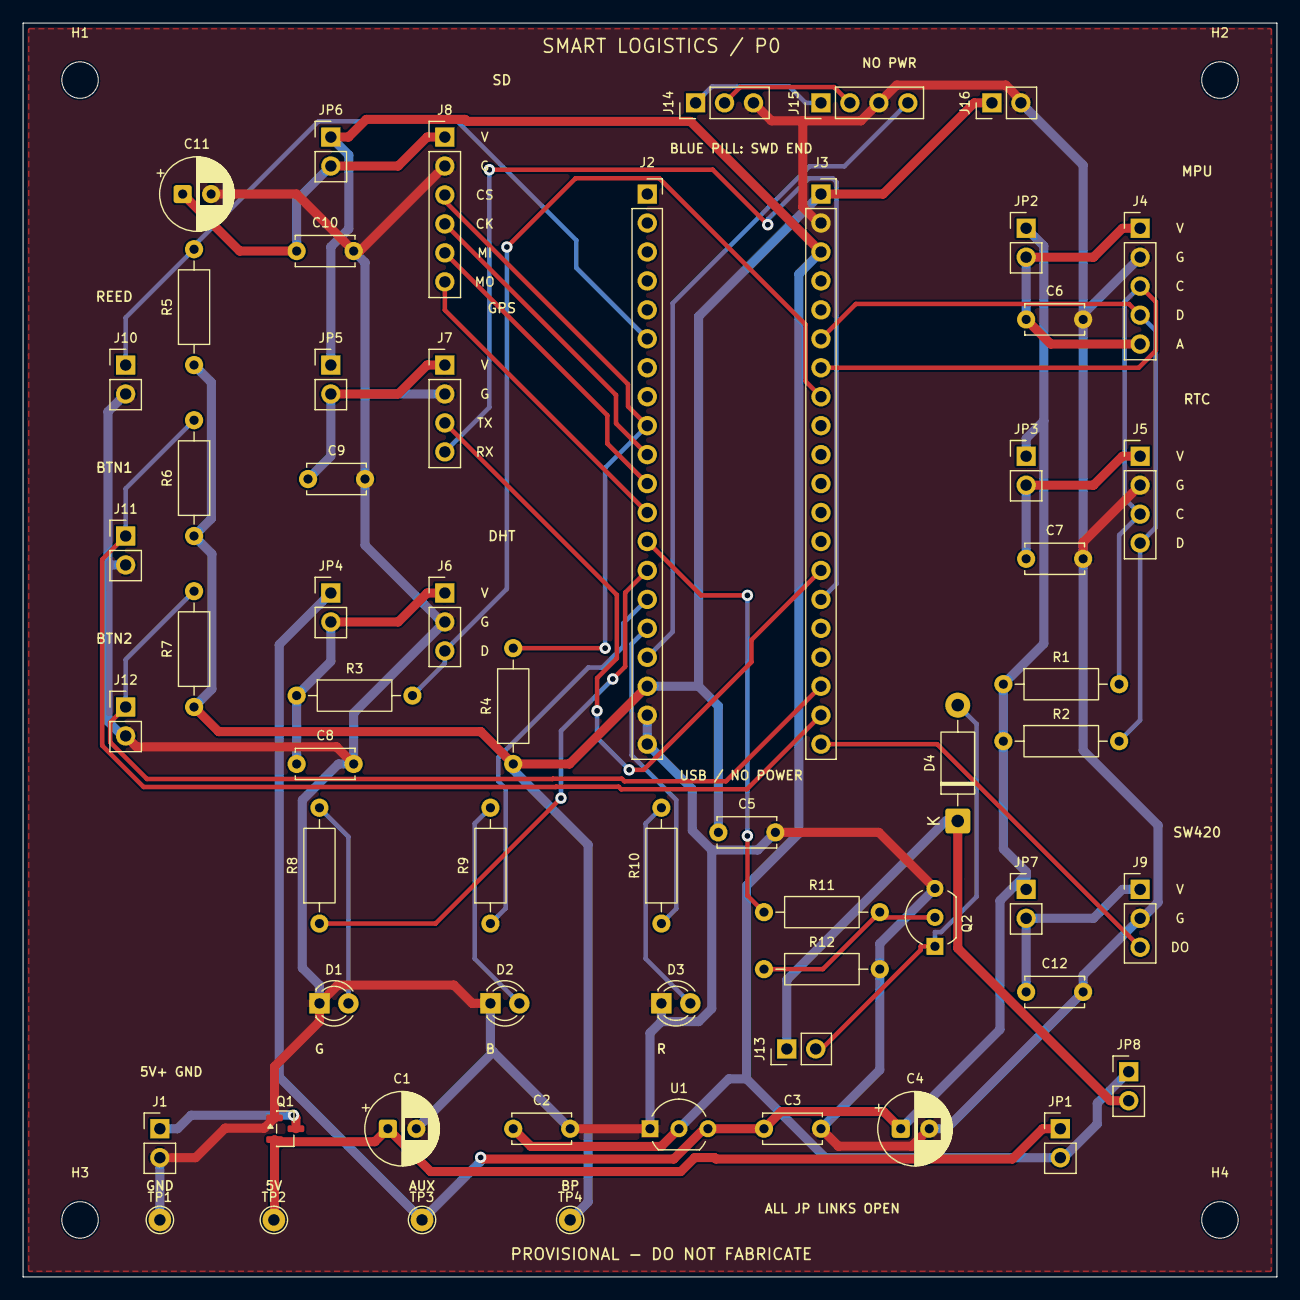
[picture p16: board SmartLogistics.kicad_pcb from above]

Board: 2 copper layers, 110.0 x 110.0 mm, 63 parts (0 on the bottom side), 38 nets.
